DisasterofPuppets/ChannelLED/.images/CYD - Batten Lights with Switches_bb.png

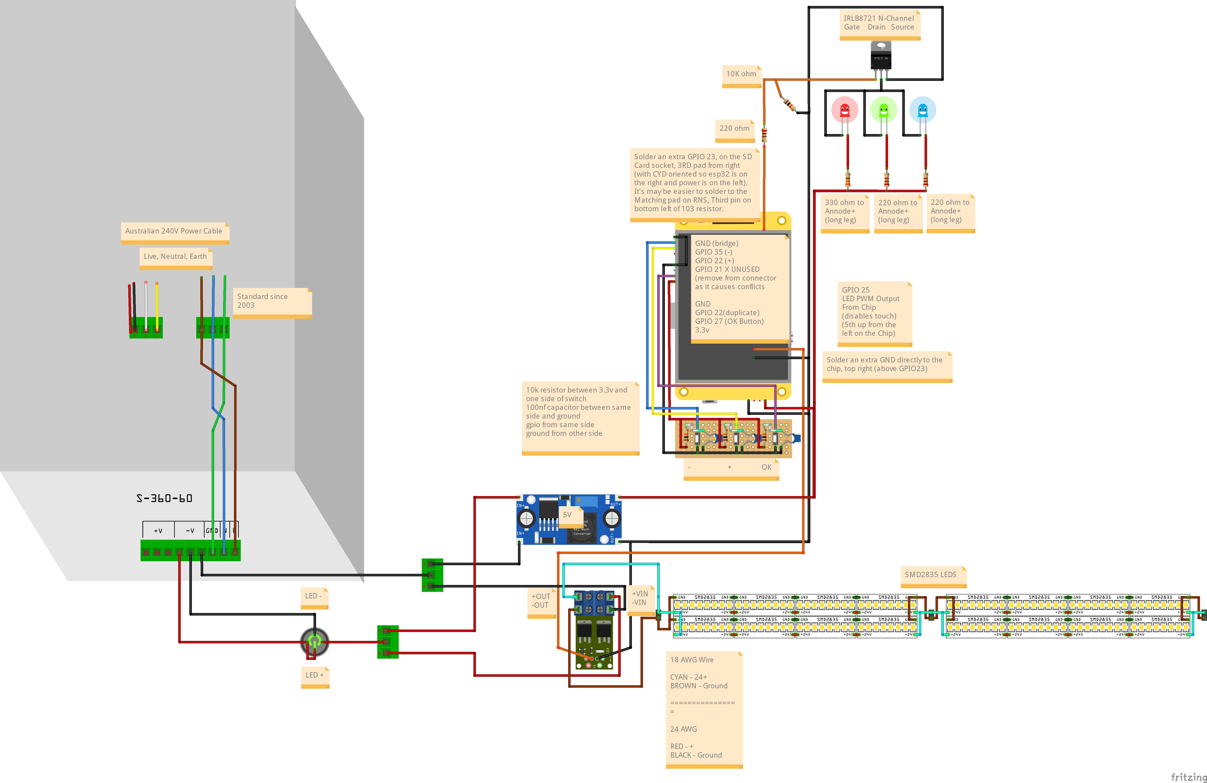
.images/CYD - Batten Lights with Switches_bb.png
