DisasterofPuppets/ChannelLED/(commit log)

2026-10-27 Rename CYD - Batten Lights with Switches_bb.png to ChannelLED_Wiring.png
2026-10-29 Update PWM frequency for LED and logo to 20kHz
    Increased PWM frequency for LED and logo to 20kHz to reduce audible noise.
    [ChannelLED.ino]
